aaronraj11/MES4-Carrier-EC/MES4_Carrier_EC/enclosure/preview.png

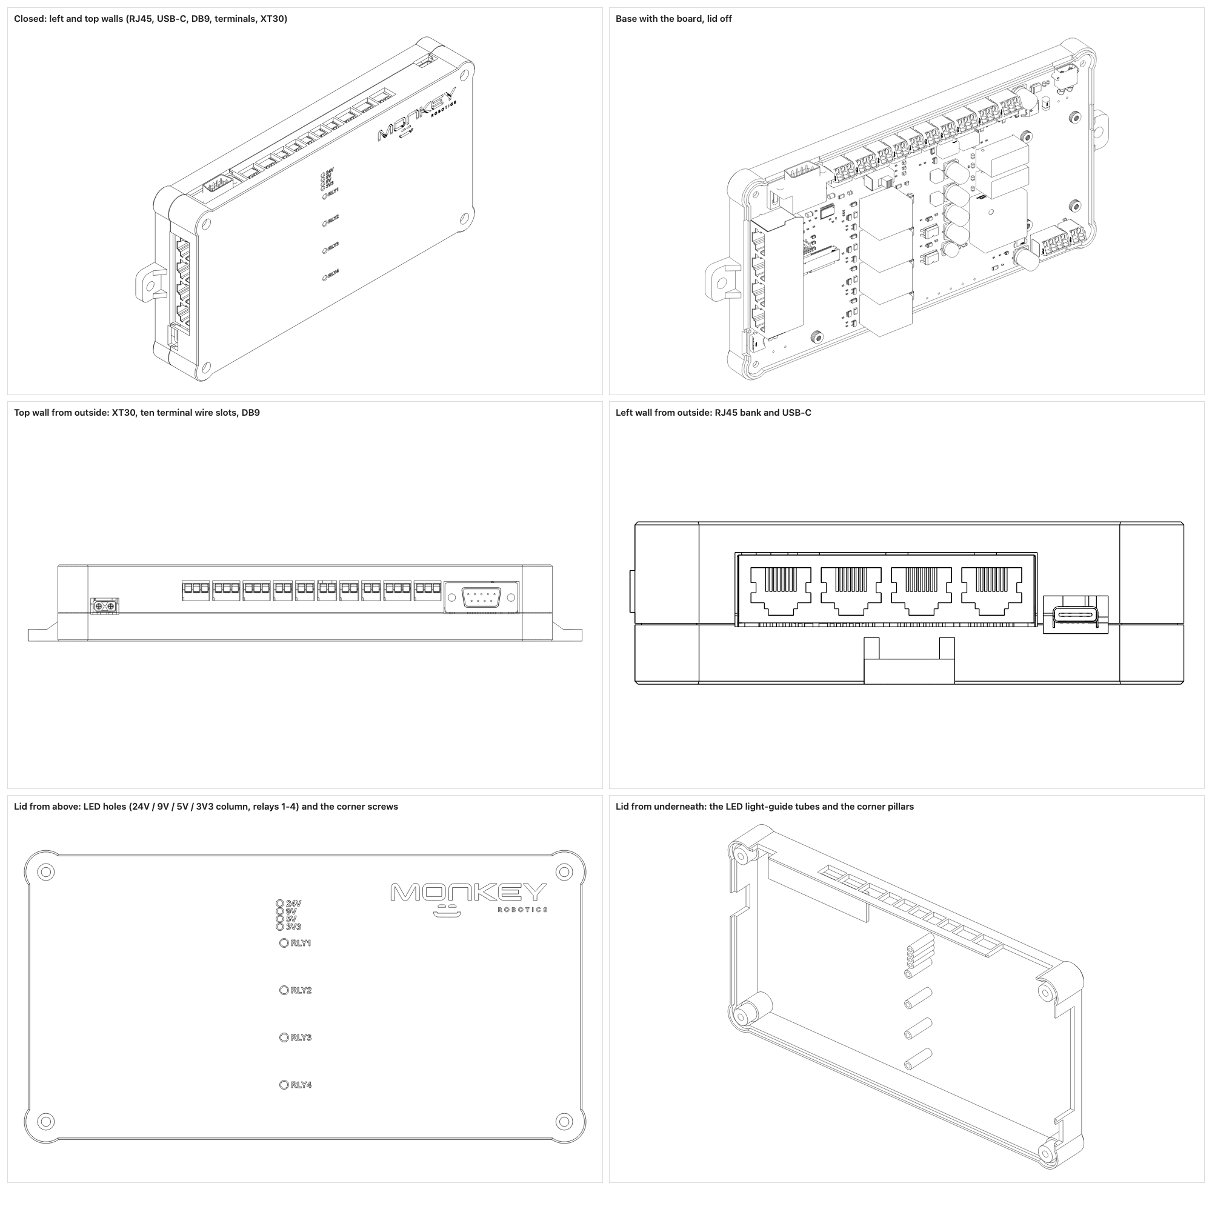
MES4_Carrier_EC/enclosure/preview.png
