aaronraj11/MES4-Carrier-EC/MES4_Carrier_EC/review/analog_guard.png

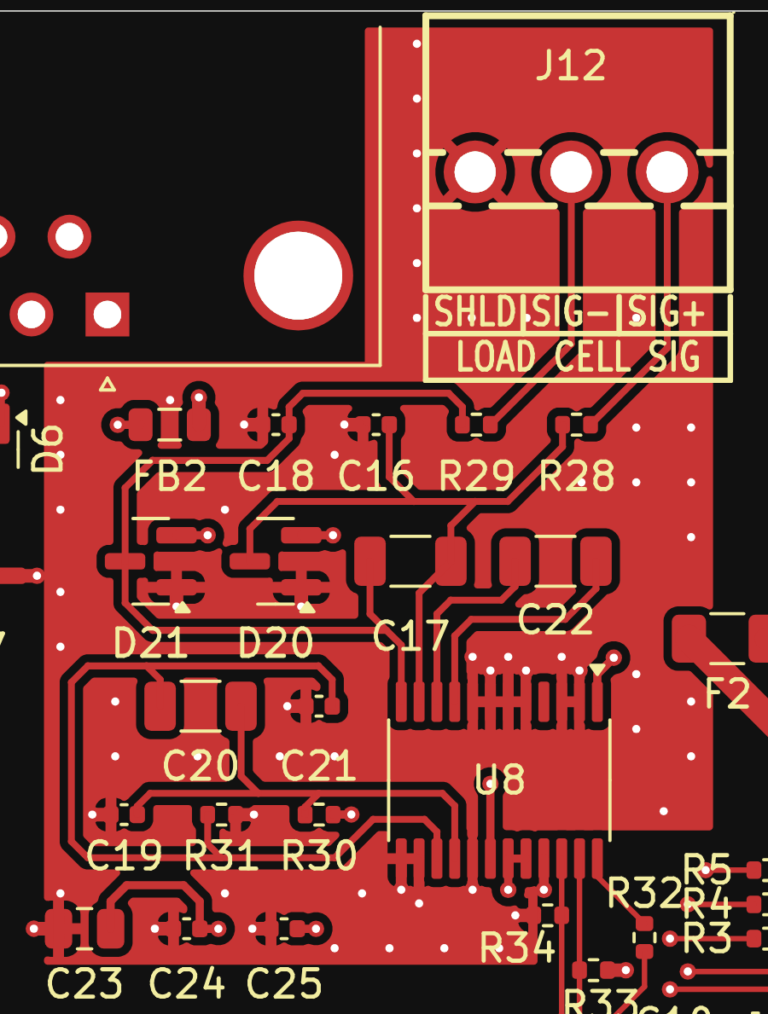
MES4_Carrier_EC/review/analog_guard.png
