aaronraj11/MES4-Carrier-EC/MES4_Carrier_EC/review/gnd_fill_B.png

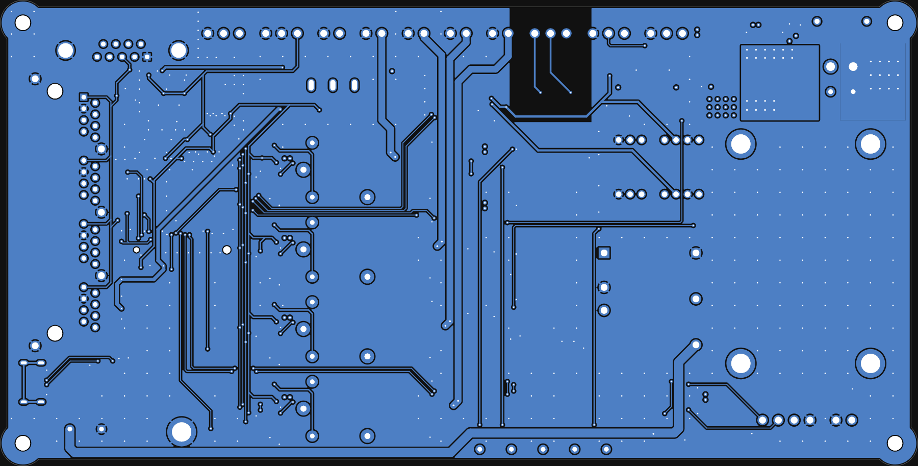
MES4_Carrier_EC/review/gnd_fill_B.png
