aaronraj11/MES4-Carrier-EC/MES4_Carrier_EC/review/gnd_fill_F.png

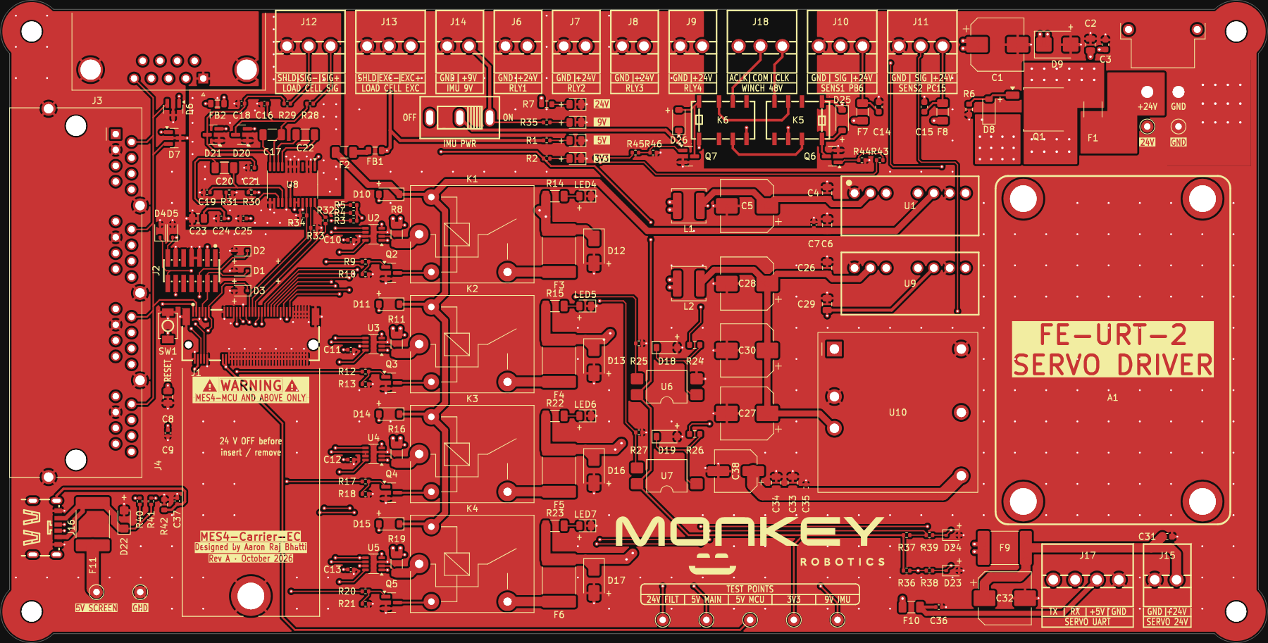
MES4_Carrier_EC/review/gnd_fill_F.png
