aaronraj11/MES4-Carrier-EC/MES4_Carrier_EC/review/plane_in1_gnd.png

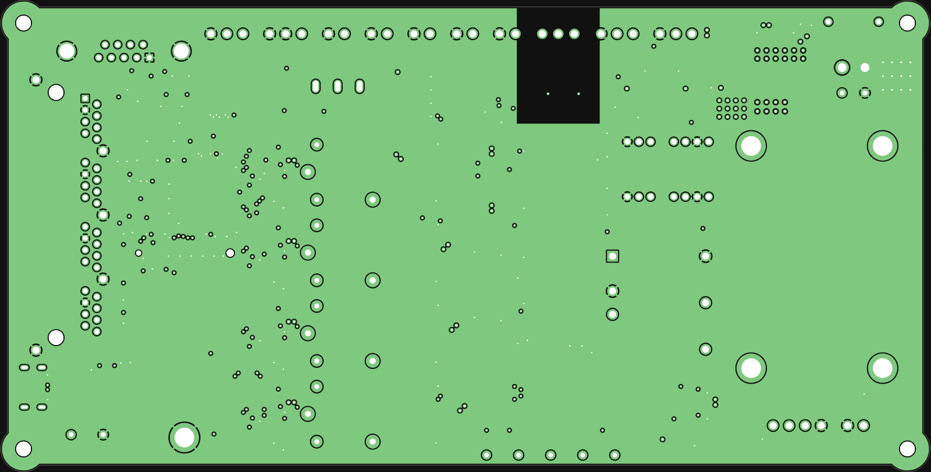
MES4_Carrier_EC/review/plane_in1_gnd.png
