aaronraj11/MES4-Carrier-EC/MES4_Carrier_EC/review/plane_in2_24v.png

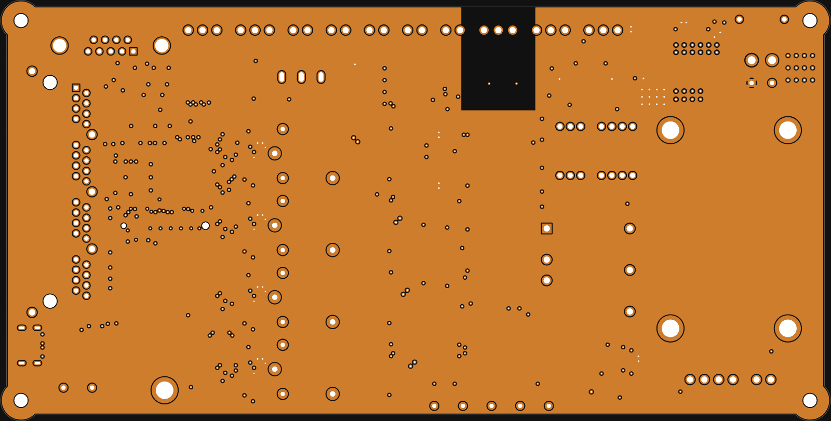
MES4_Carrier_EC/review/plane_in2_24v.png
