aaronraj11/MES4-Carrier-EC/MES4_Carrier_EC/review/routing_kelvin.png

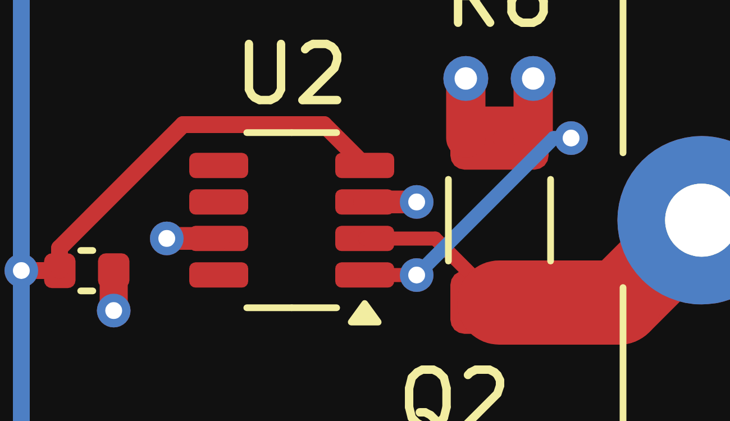
MES4_Carrier_EC/review/routing_kelvin.png
