aaronraj11/MES4-Carrier-EC/MES4_Carrier_EC/review/routing_loadcell.png

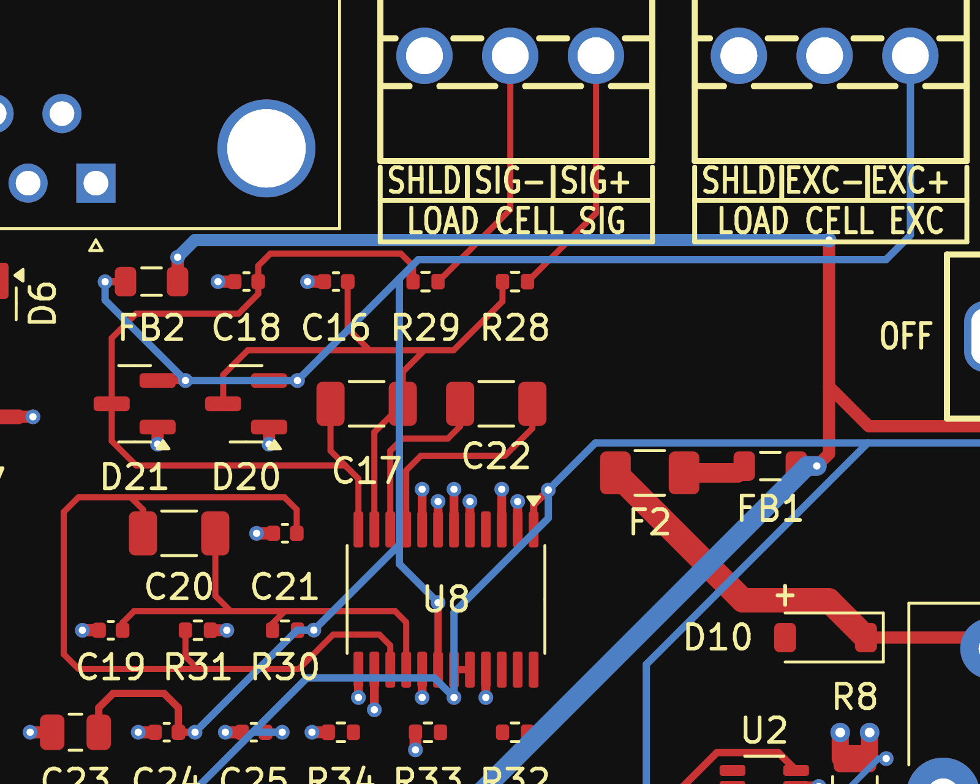
MES4_Carrier_EC/review/routing_loadcell.png
