aaronraj11/MES4-Carrier-EC/MES4_Carrier_EC/review/routing_mcu_far.png

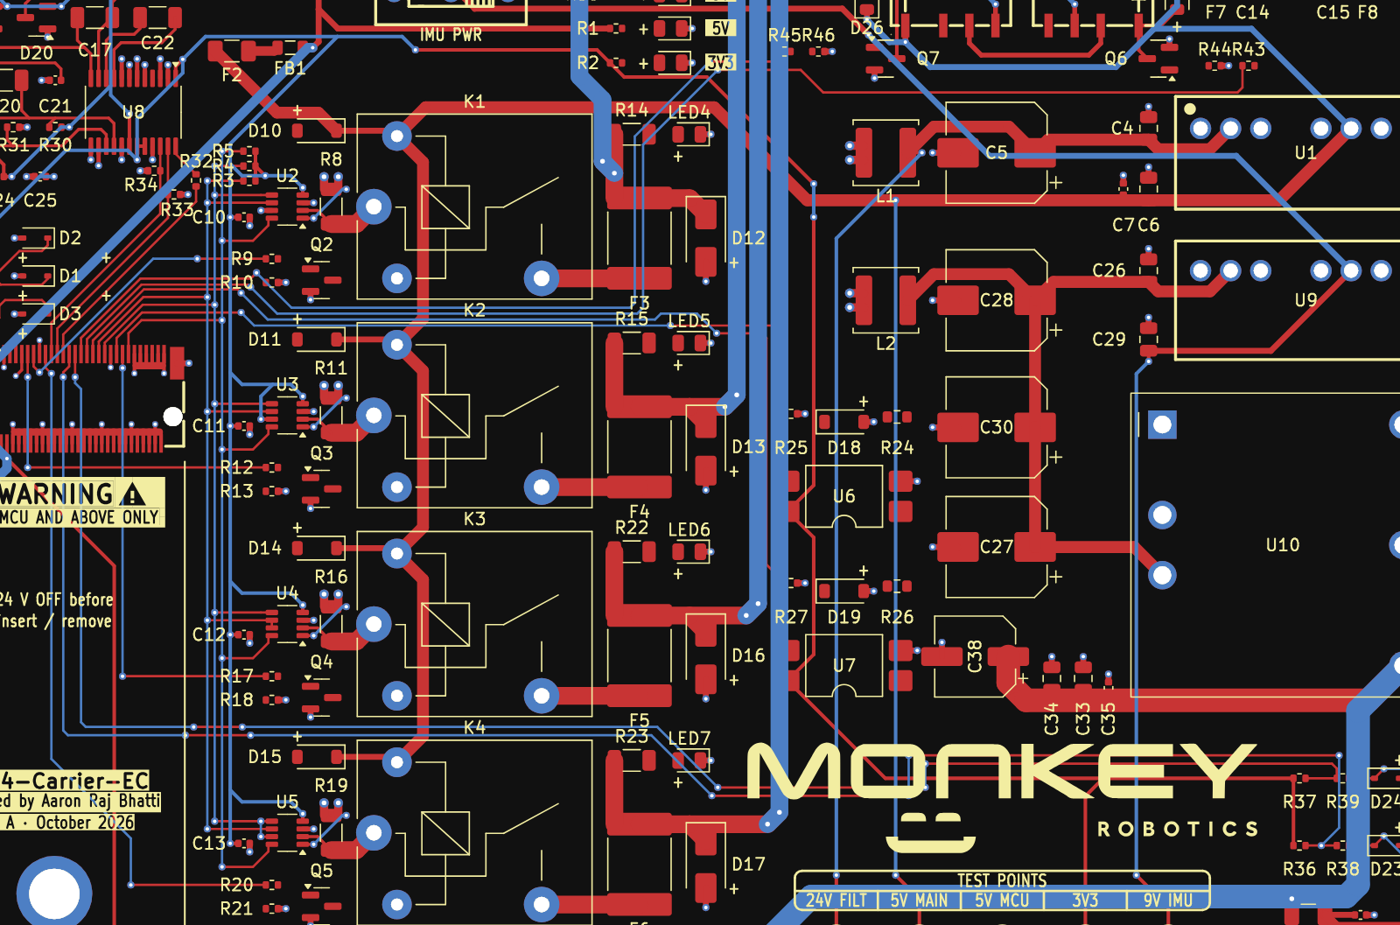
MES4_Carrier_EC/review/routing_mcu_far.png
