aaronraj11/MES4-Carrier-EC/MES4_Carrier_EC/review/routing_winch_gates.png

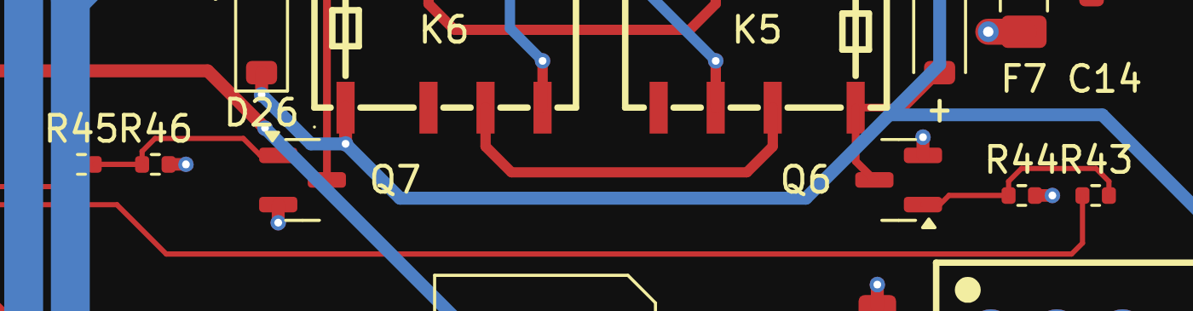
MES4_Carrier_EC/review/routing_winch_gates.png
