aaronraj11/MES4-Carrier-EC/MES4_Carrier_EC/review/silkscreen.png

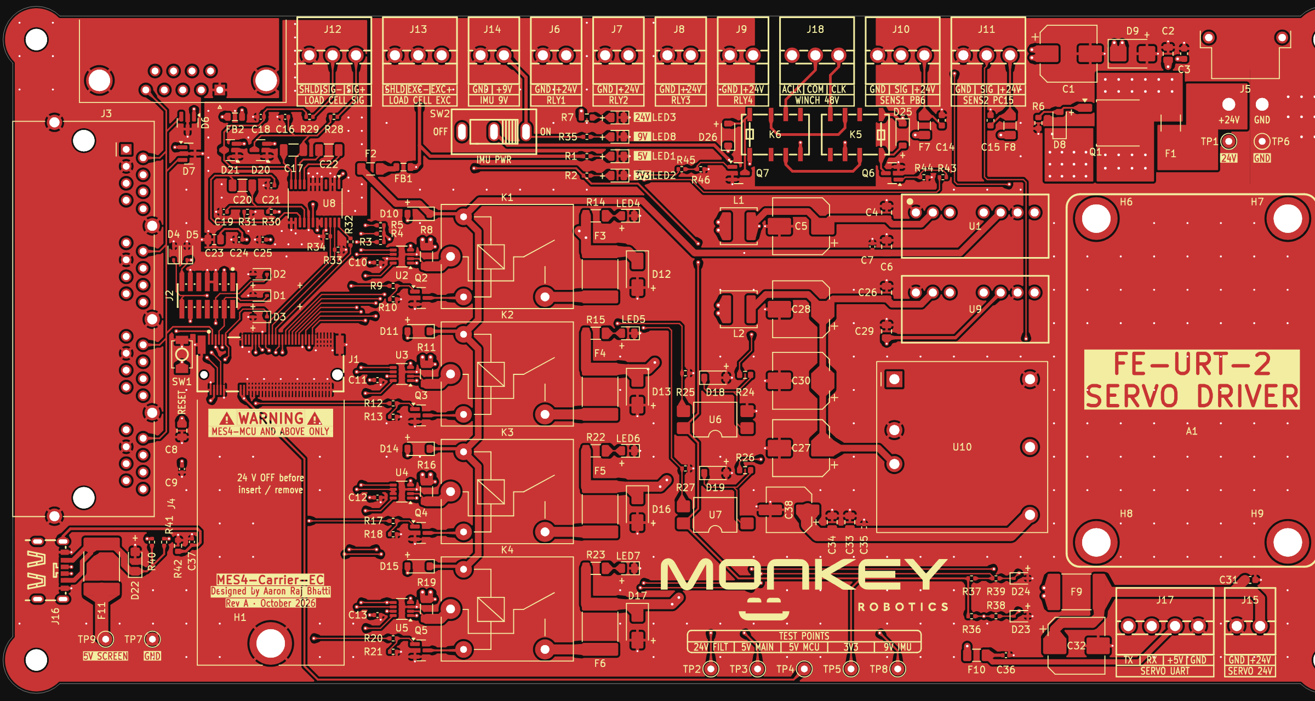
MES4_Carrier_EC/review/silkscreen.png
