aaronraj11/MES4-Carrier-EC/MES4_Carrier_EC/review/teardrops_closeup.png

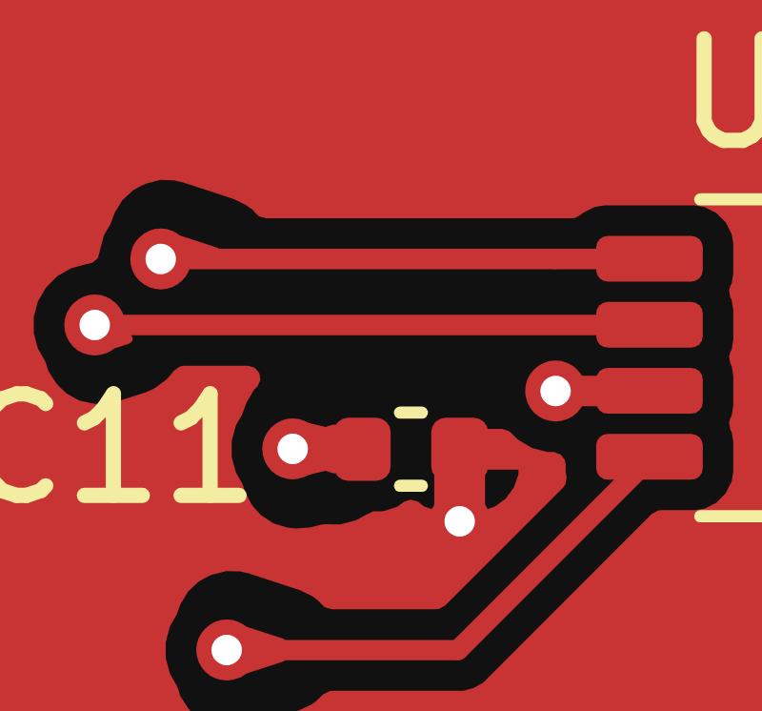
MES4_Carrier_EC/review/teardrops_closeup.png
