aaronraj11/MES4-Carrier-EC/MES4_Carrier_EC/review/tidy_mcu_fanout.png

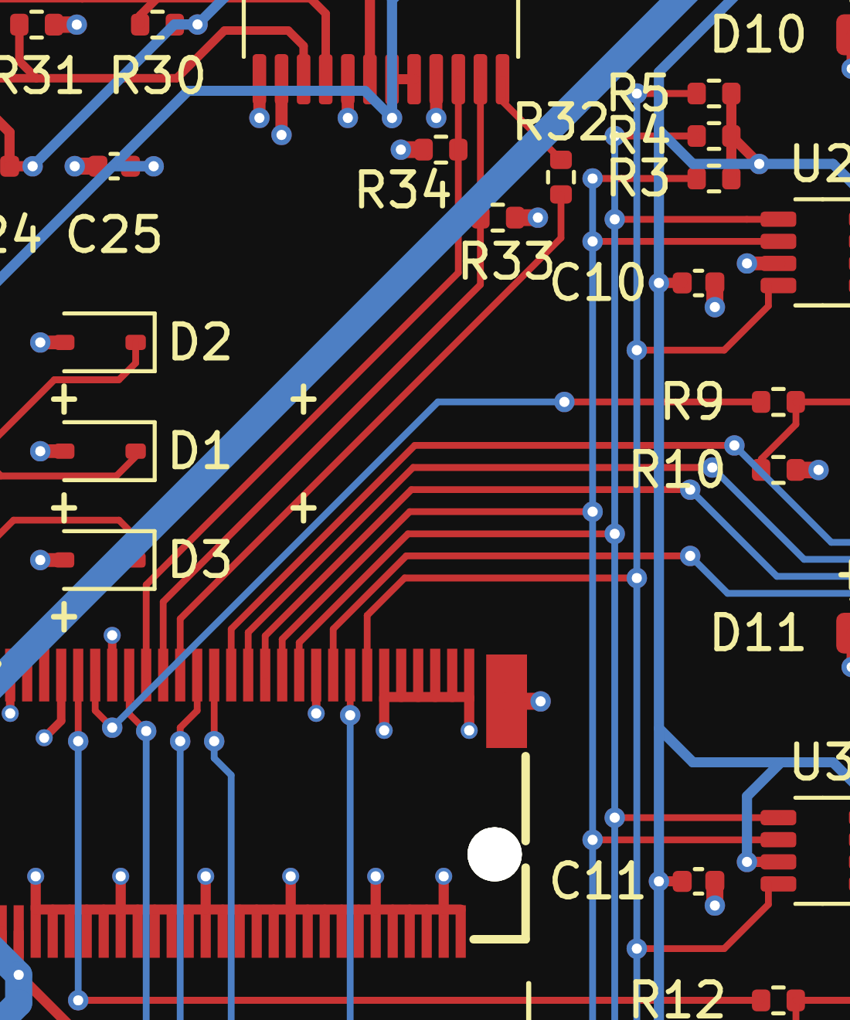
MES4_Carrier_EC/review/tidy_mcu_fanout.png
