aaronraj11/MES4-Carrier-EC/MES4_Carrier_EC/production/bom.csv

Designator | Footprint | Quantity | Value | LCSC Part #
C1, C27, C5 | CP_Elec_8x10 | 3 | 100uF 63V | C48970912
C10, C11, C12, C13, C24, C25, C35, C36, C7, C9 | 0402 | 10 | 100nF | C1525
C14, C15, C3, C31 | 0603 | 4 | 100nF 50V | C14663
C16, C18, C19, C21 | 0402 | 4 | 10nF C0G | C3855387
C17, C20, C22 | 1206 | 3 | 100nF C0G | C97946
C2, C26, C4 | 0805 | 3 | 10uF 50V | C440198
C23, C8 | 0805 | 2 | 10uF 25V | C15850
C28, C30, C32 | CP_Elec_8x10 | 3 | 47uF 100V | C48935391
C29 | 0805 | 1 | 22uF 16V | C76637
C33, C34, C6 | 0805 | 3 | 22uF 25V | C45783
C37 | 0402 | 1 | 2.2uF | C12530
C38 | CP_Elec_6.3x5.4 | 1 | 100uF 16V | C81993
D1, D2, D23, D24, D3, D4, D5 | D_SOD-323 | 7 | H5VSD3B | C20615806
D10, D11, D14, D15, D18, D19, D25, D26 | D_SOD-123 | 8 | 1N4148W | C81598
D12, D13, D16, D17 | D_SMA | 4 | SS34 | C8678
D20, D21 | SOT-23 | 2 | BAV199 | C40919
D22 | D_SMF | 1 | SMF6.0A | C19077499
D6, D7 | SOT-23 | 2 | H24VNT2B | C20615827
D8 | D_SOD-123 | 1 | MMSZ5245B | C2126
D9 | D_SMB | 1 | SMBJ30A | C113998
F1 | Fuse_Littelfuse-NANO2-451_453 | 1 | 15A | C44480
F10, F2 | 1206 | 2 | 1.1A | C126818
F11, F3, F4, F5, F6, F9 | 2920 | 6 | 3A | C22435908
F7, F8 | 1206 | 2 | 100mA | C7542926
FB1, FB2 | 0805 | 2 | 120R | C79382
H1 | Standoff_SMD_M3_H2.5mm_SMTS0M325STR | 1 | M3 standoff | C5301771
H6, H7, H8, H9 | Standoff_SMD_M3_H2mm_SMTSOM320BTR | 4 | M3 standoff 2mm | C5301780
J1 | TE_2199230-3_M.2_B-Key_4.2mm | 1 | 2199230-3 | C590859
J10 | CONN-TH_KF250NH-3.5-3P | 1 | SENS1 | C976557
J11 | CONN-TH_KF250NH-3.5-3P | 1 | SENS2 | C976557
J12 | CONN-TH_KF250NH-3.5-3P | 1 | LC SIG | C976557
J13 | CONN-TH_KF250NH-3.5-3P | 1 | LC EXC | C976557
J14 | CONN-TH_KF250NH-3.5-2P | 1 | IMU 9V | C976556
J15 | CONN-TH_KF250NH-3.5-2P | 1 | SERVO 24V | C976556
J16 | USB-C_Receptacle_PowerOnly_6P_C456012 | 1 | SCREEN 5V | C456012
J17 | CONN-TH_KF250NH-3.5-4P | 1 | SERVO UART | C976558
J18 | CONN-TH_KF250NH-3.5-3P | 1 | WINCH | C976557
J2 | Samtec_FTSH-107-01-L-DV-K_2x07_P1.27mm_Vertical_SMD | 1 | STDC14 | C5307809
J3 | DSUB-9_Pins_Horizontal_P2.77x2.84mm_EdgePinOffset7.70mm_Housed_MountingHolesOffset9.12mm | 1 | D-SUB-DR-9PCG-BB | C19077344
J4 | RJ45_HCTL_HC-RJ45-059-4-4_1x4_Horizontal | 1 | HC-RJ45-059-4-4 | C3000204
J5 | CONN-TH_XT30PW-M | 1 | 24V IN | C431092
J6 | CONN-TH_KF250NH-3.5-2P | 1 | RLY1 OUT | C976556
J7 | CONN-TH_KF250NH-3.5-2P | 1 | RLY2 OUT | C976556
J8 | CONN-TH_KF250NH-3.5-2P | 1 | RLY3 OUT | C976556
J9 | CONN-TH_KF250NH-3.5-2P | 1 | RLY4 OUT | C976556
K1, K2, K3, K4 | Relay_SPST_SANYOU_SRD_Series_Form_A | 4 | SRD-5VDC-SL-A | C140615
K5, K6 | RELAY-SMD_IMXXGR | 2 | IM03GR | C2153100
L1, L2 | L_Sunlord_SWPA5040S | 2 | 10uH | C84608
LED1 | 0805 | 1 | Red | C84256
LED2, LED3, LED8 | 0805 | 3 | Green | C2297
LED4, LED5, LED6, LED7 | 0805 | 4 | Yellow | C2296
Q1 | TO-252-2 | 1 | AGM60P90D | C5464761
Q2, Q3, Q4, Q5, Q6, Q7 | SOT-23 | 6 | AO3400A | C20917
R1, R2, R38 | 0402 | 3 | 1k | C11702
R10, R13, R18, R21, R33, R34, R44, R46 | 0402 | 8 | 100k | C25741
R11, R16, R19, R8 | 1206 | 4 | 30mΩ | C5375399
R12, R17, R20, R28, R29, R30, R31, R32, R39, R43, R45, R9 | 0402 | 12 | 100Ω | C25076
R14, R15, R22, R23 | 1206 | 4 | 3.3k | C26032
R24, R26, R6, R7 | 0603 | 4 | 10k | C25804
R25, R27, R36, R37, R40, R41, R5 | 0402 | 7 | 10k | C25744
R3, R35, R4 | 0402 | 3 | 2.2k | C25879
R42 | 0603 | 1 | 1M | C22935
SW1 | SW_SMD_TS-1088_4x3mm | 1 | RESET | C720477
SW2 | SW-TH_SHOU-HAN_SS12D10G4 | 1 | SS12D10G5 | C7431054
U1 | PWRM-TH_YLPTEC_URXXXXXS-6WR3 | 1 | URB2405S-6WR3 | C3031185
U10 | PWRM-TH_YLPTEC_URBXXXXYMD-20WR3 | 1 | URB2405YMD-20WR3 | C5369777
U2, U3, U4, U5 | TSOT-23-8_TI_DDF | 4 | INA236 | C5443912
U6, U7 | SMDIP-4_W9.53mm | 2 | PC817 | C66405
U8 | TSSOP-24_4.4x7.8mm_P0.65mm | 1 | ADS1232IPWR | C27919
U9 | PWRM-TH_YLPTEC_URXXXXXS-6WR3 | 1 | URB2409S-6WR3 | C7468814
