aaronraj11/MES4-Carrier-EC/MES4_Carrier_EC/enclosure/MES4-Carrier-EC_base.step

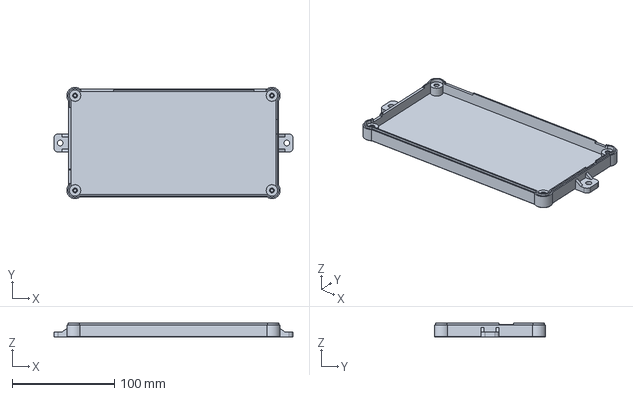
[picture p25: CAD file, 2026-10-29]
MES4_Carrier_EC/enclosure/MES4-Carrier-EC_base.step
234.2 x 109.1 x 13.6 mm
