aaronraj11/MES4-Carrier-EC/MES4_Carrier_EC/enclosure/MES4-Carrier-EC_lid.step

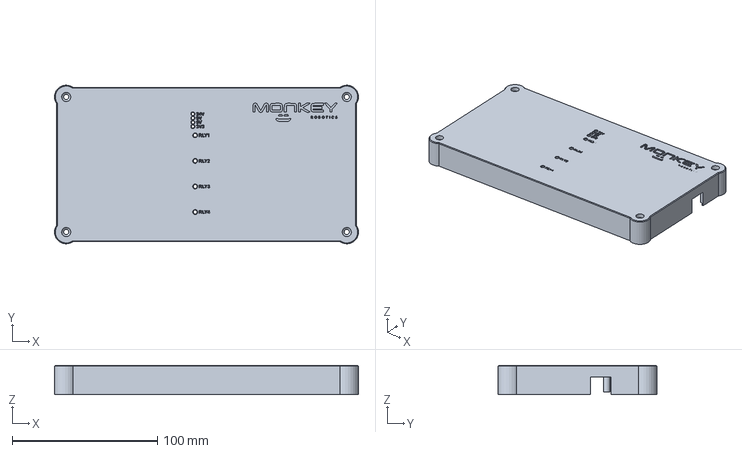
[picture p27: CAD file, 2026-10-29]
MES4_Carrier_EC/enclosure/MES4-Carrier-EC_lid.step
209.1 x 109.1 x 20.2 mm
