aaronraj11/MES4-Carrier-EC/(list of files, cad)

Other CAD files:
MES4_Carrier_EC/enclosure/MES4-Carrier-EC_base.stl
MES4_Carrier_EC/enclosure/MES4-Carrier-EC_lid.stl
