aaronraj11/MES4-Carrier-EC/MES4_Carrier_EC/review/cpl_r4_fix.png

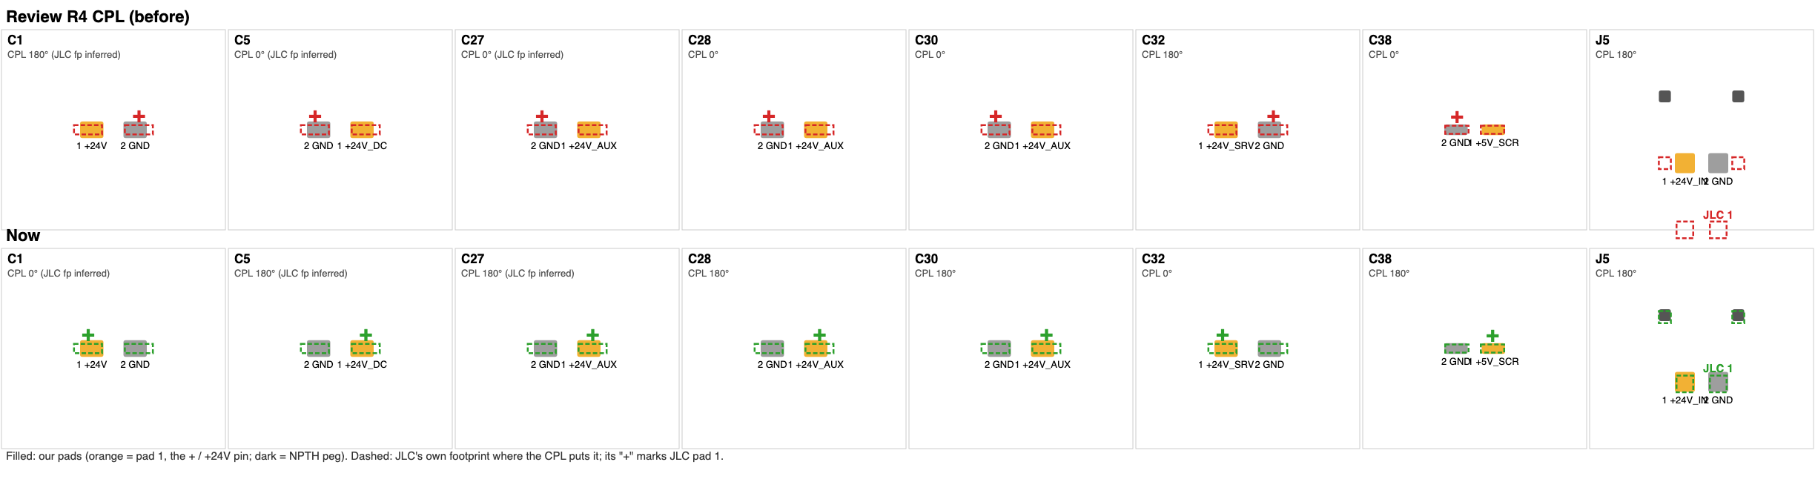
MES4_Carrier_EC/review/cpl_r4_fix.png
