aaronraj11/MES4-Carrier-EC/MES4_Carrier_EC/review/MES4_Carrier_EC_1to1_A4.pdf

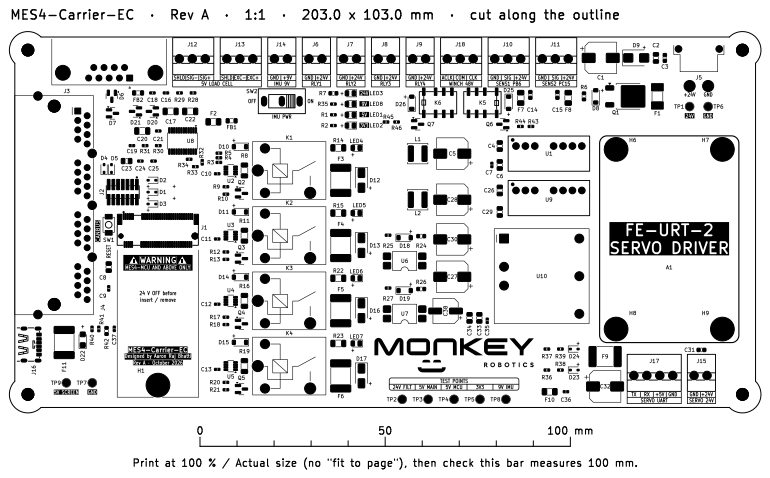
[picture p29: page 1]
