aaronraj11/MES4-Carrier-EC/(commit log)

2026-10-27 Add the MES4-Carrier-EC schematic, generator and handoff notes
    E-Crawler carrier for one MES4-MCU module, ten A3 pages, built from the
    MES4-Flasher sheets plus new blocks. ERC: 0 errors, 0 warnings; every
    symbol pin has a footprint pad and every bought part an LCSC number.
    - 24 V XT30 input: 15 A fuse, P-MOSFET reverse-polarity block, SMBJ30A,
    pi filters, URB2405S-6WR3 logic supply and a fused module 5 V feed.
    - Four relay outputs per MES4-CIF section 7: AO3400A, coil feedback,
    INA226 per channel, 3 A PTC.
    - Two Autonics PNP sensor inputs (PC817) and the Flasher's ADS1232 load
    cell.
    - CAN: DB9 male to the IPC (1 GND, 3 CAN_H, 5 CAN_L) and a 1x4 RJ45
    without magnetics, H24VNT2B ESD a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
2026-10-27 Put relay coil feedback back on PA0-PA3 (MES4 GPIO standard)
    All 14 module GPIOs now follow the MES4-CIF §2c table. The TCA9535 is
    removed from the Relays 3-4 sheet and J1 fingers 43/45/47/49 drive the
    relay 1-4 feedback dividers again. The winch relays are left undriven
    (gate inputs no-connected, 100k pull-downs hold them off) until they
    move to the TCA9535 + photoMOS design (HANDOFF.md step 2).
    Removing U4 renumbers U5-U12 to U4-U11 and C15-C45 to C14-C44; the
    README refs follow. Adds generator/checks.py (pin/pad, single-pin nets,
    duplicate UUIDs, LCSC numbers), run by run.sh after ERC.
2026-10-27 Drop relay coil feedback; winch on PA0/PA1, servo on USART2
    User decision: free the four feedback pins instead of adding an I²C
    expander. The Flasher template's 10k/15k/10 nF dividers are removed from
    all relay channels and relay diagnosis is INA226-only. PA0/PA1 drive the
    IM03GR winch relays again and PA2/PA3 carry the door servo UART
    (USART2), so the SC16IS740 bridge, its crystal and caps, and the unused
    TCA9535 code are removed. This deliberately differs from the MES4-CIF
    §2c GPIO table; the GPIO map, root notes, README and HANDOFF say so.
    189 parts, ERC clean, checks.py passes. README refs follow the
    renumbering.
2026-10-27 Add module finger map page and FE-URT-2 3.3 V note
    New page 11 (Pinout): a KiCad table of every MES4-MCU finger with its
    STM32 port, function, what this carrier connects to it, the carrier
    parts, the MES4-CIF §2c standard use and notes. It follows the MES4-MCU
    U1 pin map style (colour-coded Function column, spanned finger-group
    rows); the PA0-PA3 rows mark where this board differs from §2c. The
    builder gains table() with per-cell fills and row spans, and cell text
    resolves {tag} references.
    The AuxPower servo note, README and HANDOFF now say to set the FE-URT-2
    level switch to 3.3 V: at 5 V its TX exceeds PA3's limit while the
    module is unpowered and back-feeds the 3V3 through the RX pull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
2026-10-27 Isolate the 48 V winch side, add servo TX pull-up, tidy block diagram
    Winch: J18 and the WINCH_* / ILK_* nets already touch only relay
    contacts; they now form net class Winch_48V (0.6 mm clearance), and the
    Winch sheet, README and HANDOFF state the isolation rules (>= 2 mm to
    other copper, no GND pour under J18, no ESD to GND on J18).
    Servo: R37 10k pull-up holds PA2 (TX) idle HIGH while the MCU is in
    reset. AuxPower/Winch refs R37-R45 shift by one; README follows, and the
    LED8 resistor ref is corrected to R35.
    Block diagram: door servo block, winch and servo links from the module,
    24 V routed so it never crosses a signal line, channel lines on an even
    5.08 mm pitch.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
2026-10-27 Address design review R1: INA236, J15 polarity, review fixes
    M1: U2-U5 are now TI INA236AIDDFR (C5443912, 50 V abs max, TSOT-23-8)
    instead of the INA226 (40 V), since the SMBJ30A clamps at up to 48.4 V.
    A project INA236 symbol keeps the INA226 body so the Flasher relay
    wiring lands on the same pins; A1 and VBUS are gone (bus read on IN-),
    addresses 0x40-0x43 via A0 = GND / VS / SDA / SCL. Same CONFIG / CAL /
    MASK / ALERT values; notes give the 1.6 mV bus LSB and Device ID.
    M3: J15 servo 24 V is pin 1 = +24 V like every power terminal.
    L4: R38 servo RX series resistor 1k (limits PA3 back-feed).
    L2: "current present" threshold 3 mA. L6: Power notes use 13 A / 2.2 W.
    M2 / L5: silkscreen notes f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
2026-10-27 Add whole-board LTspice simulations, IMU notes and the R2 review package
    sim/: 16 LTspice benches grouped by schematic sheet (Power, Relays,
    Sensors, LoadCell, AuxPower, IMU, Winch, Main) on the real supply chain
    (DDR-480C-24 at 24 V and a 24 V Li-ion pack via XY-CD63L, diode-OR'd by
    an Autoro AB20). run_sims.py runs them, make_report.py builds
    report.html. All pass; the IEC 0.5 kV surge is not applicable to this
    internal, isolated supply. Raw waveforms and logs are git-ignored.
    IMU: 3DM-CV7-AHRS on the C-Series Connectivity Board (6212-3009). The
    AuxPower and Main notes, README and HANDOFF now say J14's 9 V goes to the
    board's Vaux only (never Vpri), not together with the USB cable; the
    po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
2026-10-27 Record datasheet checks in the report, review package and HANDOFF
    All three pass: U1 / U9 / U10 YLPTEC converters allow a 50 V input surge
    for 1 s (PWR2 peaks at 40 V); Q1 AGM60P90D is rated -360 A pulsed (plug-in
    inrush 100 A); F1 Littelfuse 0451015 melting I2t is 97.8 A2s (inrush
    0.95 A2s). PWR2 is now a plain pass, and the hold-up note mentions the
    converters' 5.5-6.5 V undervoltage shut-off. Review package rebuilt.
2026-10-27 Import all footprints into the PCB; TI land pattern for the INA236
    MES4_Carrier_EC.kicad_pcb: all 190 footprints and 146 nets, grouped by
    schematic sheet below the 200 x 100 mm outline, ready to place. Each
    footprint carries its symbol path (F8 updates it instead of duplicating),
    nets, LCSC number and BOM setting. DRC: schematic parity 0 issues,
    0 clearance errors; 450 unconnected items (unrouted).
    generator/import_footprints.py does the one-time import with KiCad's
    pcbnew Python and refuses a board that already has footprints.
    U2-U5 INA236 now use the project footprint TSOT-23-8_TI_DDF (TI DDF0008A
    land pattern: 1.05 x 0.45 mm pads, rows 2.6 mm apart). KiCad's generic
    TSOT-23-8 left 0.15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
2026-10-27 Group footprints that must sit together into KiCad groups
    generator/group_footprints.py puts all 190 footprints into 21 named
    groups (24 V input, logic DC/DC, module 5 V feed, GND joint, M.2 socket,
    ST-Link, mounting holes, DB9, RJ45, one per relay channel with its shunt
    and INA236, one per sensor, load cell, aux filter, IMU, screen, servo,
    winch) and packs each as a labelled block below the board outline. Parts
    already inside the outline are not moved; old labels and groups are
    stripped from the file text first, so it can be rerun (KiCad closed).
    DRC: schematic parity 0 issues, no clearance errors; 450 unconnected
    items (unrouted). HANDOFF lists the script.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
2026-10-27 Centre the mounting holes on the board's dog-ears
    H2-H5 (M3, 3.2 mm) sit on the centres of the four 5 mm Edge.Cuts
    dog-ear arcs, taken from the outline itself: (53.4355, 52.9355),
    (246.3645, 52.9355), (246.3645, 145.8645), (53.4355, 145.8645).
    All four are locked. DRC unchanged: schematic parity 0 issues, no
    clearance errors.
2026-10-27 PCB placement, FE-URT-2 and GPS mounts, smaller screen converter, review R3
    Placement: all terminals, USB-C and XT30 face the top edge (CAN DB9/RJ45 on
    the sides), power block (U1, U9, U10, filters, GND joint) under the 24 V
    input, relay bank and winch block below the terminal row, MES4-MCU slot
    grouped with the Flasher's slot silkscreen. Feetech and GPS mounts parked
    off-board until the layout is final.
    Mounts: FE-URT-2 on 4 x YIYUAN SMTSOM320BTR M3 x 2 mm SMD standoffs (H6-H9,
    C5301780) as on the MES3 carriers, board-only outline with a footprint
    keep-out; simpleRTK4 Dual on 3 x SMTSOM365BTR M3 x 6.5 mm standoffs
    (H10-H12, C5301796) + 12 mm spacers, with its STEP.
    U10: URB2405LD-20WR3 (2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
2026-10-27 Add the EasyEDA 3D model to U10 (URB2405YMD-20WR3)
    STEP from the EasyEDA/LCSC library part C5369777. Its origin is the body
    centre on the board surface and its pins land on the footprint's pads
    (checked in FreeCAD), so no offset or rotation. Attached in the footprint
    builder, the library footprint and U10 on the PCB.
2026-10-27 Place every part, tidy the converter block, leave out the GPS mount
    - Converter block: U1/U9/U10 right-aligned in one line beside the
    FE-URT-2 (2.5 mm channel), all their caps on the left in routing lanes.
    - STDC14 (J2) and RESET above the M.2 connector, ESD diodes beside J1;
    ADS1232 load-cell front end below the MES4-MCU; sensor optos below the
    converter block.
    - Supply LEDs (24V/9V/5V/3V3) in one array with knockout voltages, as on
    the Flasher; pull-ups beside it.
    - Terminal label boxes on the FE-URT-2 connectors J17/J15 (moved up 2 mm).
    - GPS (simpleRTK4) mount left out for now: GPS_MOUNT = False in gen.py
    drops H_GPS1-3; A2 and the standoffs are off the PCB.
    - Top-row reshuffle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
2026-10-28 Add the EasyEDA 3D model to the 1x4 RJ45 (J4, HC-RJ45-059-4-4)
    The generated footprint had no model. The LCSC/EasyEDA STEP of C3000204 is
    aligned on its pegs and seating plane (measured in FreeCAD): offset
    (71.495, -10.31, 13.5) mm, no rotation.
2026-10-28 One ground and a 4-layer board
    - GND_24V merged into GND (ONE_GND in gen.py): every GND_24V power symbol
    becomes GND, net tie NT1 left out, notes reworded. Symbol UUIDs unchanged,
    so every footprint keeps its link.
    - 4 layers, JLC04161H-7628 stackup (1.6 mm, ENIG): Top Signal / GND plane
    (In1) / +24V plane (In2) / Bottom Signal.
    - Net classes: Out_3A (1.5 mm) for +24V_SRV, +5V_SCR, VBUS_SCR; +24V_AUX to
    24V_Power; +5V_SRV, +9V_IMU, IMU_9V to Power; INA236 shunt pattern fixed
    (Net-(U*-IN-)).
    - J1's NPTH holes back to F&B.Cu as in its library footprint.
    ERC 0, checks passed, DRC 11 silkscreen warnings, schematic parity clean.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
2026-10-28 Placement and silkscreen pass: ADS by the load-cell inputs, test points, logo
    - Left column top to bottom: ADS1232 under J12/J13 (input filter toward the
    connectors), STDC14 + ESD grid, then the MES4-MCU slot moved down 22.3 mm;
    RESET (SW1) beside J1 with the 5 V socket caps C8/C9.
    - Test points named by what they feed (TP_NAME in gen.py: 24V, 24V FILT,
    5V MAIN, 5V MCU, 3V3, 9V IMU, 5V SCREEN); bottom row in a Flasher-style
    rounded box, 24V/GND under the XT30, 5V SCREEN/GND by the screen USB-C.
    - Supply LEDs centred between SW2 and the winch block; short knockout labels
    all one box size (drawn as cut-out silk shapes).
    - + at the anode of every two-pin diode and LED; SW2 marked IMU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
2026-10-28 GND vias for every SMD GND pad
    106 vias (0.6/0.3) to the In1 GND plane, each on one straight 0/90-degree stub
    straight off the end of its pad (IC pins straight out along the pin), 0.1 mm
    from the pad edge; U8's 0.65 mm pins staggered to 0.6 mm for hole spacing.
    Vias keep clear of other parts, board silkscreen and the escape lanes of
    fine-pitch signal pins; labels in the way moved instead. J1's 0.3 mm M.2
    fingers are left for the escape routing.
    Made room: ESD grid at 3.2 mm pitch with + under each anode, J2 label vertical
    on its left, C8/C9 GND pads down, LED voltage boxes 0.6 mm out, D22 down 1.5 mm;
    diode + marks re-placed beside the anodes.
    DRC 14 silkscreen warnings, schematic parity c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
2026-10-28 Net classes sized by current, +24V plane vias, fused M.2 GND bars
    - Net classes by current: Power_Small 0.3, Power 0.5, 24V_Power 1.0,
    Out_3A 1.5, Input_15A 3.0, Winch_48V 0.6 clearance, CAN and LoadCell
    pairs; router track, via and diff-pair presets
    - +24V vias into the In2 plane, one pattern per part type: two vias
    across the pad end on the shunts (R8/R11/R16/R19), L1/L2, F9, C1, D9;
    one via on the small parts; all straight off the pad
    - J1 (M.2): GND vias on every GND finger, inward under the socket body;
    runs of 3+ GND fingers (24-74, 65-75) fused by a bar with a few vias
2026-10-28 Handoff: PCB state, routing order, workflow; PCB helper scripts
    - HANDOFF.md "Start here": what's done on the PCB, net classes, DRC
    baseline, the 13-group routing order, the KiCad workflow and the
    user's via style
    - generator/pcb/: the GND / +24V / J1 via scripts and the strip helpers
2026-10-28 Route high-current paths and supply rails by hand
    High current: 24 V input pours (J5 -> F1 -> Q1, drain copper on both
    layers with thermal vias, +24V via field into In2, GND pours and vias at
    J5, J5 pins solid to the planes); relay load paths at 1.5 mm with every
    output on a B.Cu lane; servo 24 V above J17; screen 5 V on a 2 mm B.Cu
    trunk to F11 / J16.
    Supply rails: +24V_DC, +24V_AUX, +5V_24 (relay and winch coils), module
    5 V, +3V3_MOD, IMU 9 V, servo 5 V, sensor supplies and the test points.
    All paths are hand-placed coordinates in generator/pcb/route_*.py:
    45-degree bends only, one width per run, and the load-cell inputs,
    pull-up pads and J1 escapes kept free. LC_EXC+ is left for the
    loa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
2026-10-28 Route the winch relays by hand, isolate them from the planes
    J18 to K5 / K6 contacts and interlock: CLK and COM-to-K6 on F.Cu,
    ACLK and COM-to-K5 dropped from J18's through-hole pins on B.Cu to a via
    under the relay body (J18's order is mirrored against K6's pins),
    ILK_CLK between the relays' pin rows, ILK_ACLK below them. Coil drive
    to the flyback diodes and FETs; K6's coil+ gets its own via onto the
    B.Cu +5V_24 feed so coil- stays 2 mm from the live unused NC1 pin.
    A no-pour rule area on all copper layers keeps the GND / +24V planes
    (and any later outer GND fill) 2 mm off J18, the contacts and the
    winch vias. winch_clear.py checks the 2 mm rule on every layer.
    Shared path helpers moved t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
2026-10-28 Route the analog front ends, CAN bus and servo UART by hand
    INA236 Kelvin pairs: 0.25 mm sense lines tapped at the shunt pads; IN+
    crosses IN- on B.Cu between two vias (pin order vs shunt pads), same
    pattern on all four channels.
    Load cell: input pair, CAPA / CAPB and the REFP / REFN network all on
    F.Cu with no vias; LC_EXC+ joins FB2, the clamp diodes, J13, AVDD, R30
    and C24 on B.Cu.
    CAN bus J3 - D6 - D7 - J4 ports 1-4 down x 72.9, L on F.Cu and H on
    B.Cu (each RJ45 port's H pin sits beside its L pin). Servo UART at J17
    on B.Cu past the +24V_SRV tracks.
    J1's fingers (CAN / UART ends, debug, I2C, GPIO) are left for the
    planned MCU escape.
    DRC: the 14 accepted notes, schematic parity 0, 8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
2026-10-28 Finish routing: MCU escape, local nets, verify and tidy
    Route every remaining connection by hand (0 unrouted, DRC at the 14
    accepted notes, schematic parity 0):
    - MCU escape off J1: west corner (CAN, SWD, NRST, VCP to J2 / SW1 /
    D1-D5), ADC lines, relay gates, I2C / PA15 bus, far-east GPIO
    - local nets: relay drive, winch gates, sensor inputs, LEDs, screen
    USB-C CC and shield
    - placement moves for routability (R3-R5, D4/D5, D1/D2, R32-R34,
    a few J1 / J2 GND vias); +3V3 trunk moved east of the SWD crossings
    Verify and tidy: verify_nets.py checks the board against the schematic
    netlist and copper connectivity; audit.py reports bends, tees, jogs and
    uneven bundles (now none on any net);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
2026-10-28 Add the analog GND guard; check the planes
    - Analog guard: a priority-2 GND zone on F.Cu around the load-cell path
    (J12 -> R28/R29 -> filter caps / clamps -> ADS1232, REF / CAP caps),
    0.3 mm from the analog lines, kept off the ADS1232's digital corner and
    J3, stitched to In1 by 40 vias
    - Planes checked: every zone fills as one piece (no islands), no starved
    thermals, no via slots; only winch nets cross the winch cut-out
    - Renders of the guard and both inner planes
2026-10-28 Add outer GND fill, teardrops and the silkscreen pass
    - route_local.py fill: GND pours on F.Cu / B.Cu at priority 0 (24 V-input
    pours raised to 1, analog guard 2), moat round the analog guard,
    5 mm stitching-via grid to In1; U7 pin 2 connected solid.
    - teardrops.py: KiCad-style straight pad / via teardrops on every
    non-GND track end, centred on the track axis.
    - silk.py: drop the unprintable 0.12 mm pin-1 dots (board and the 10
    project-library footprints), widen strokes to 0.15 mm, move crowded
    labels, put the 19 fab-only refs on silk (H2-H5 stay unlabelled),
    keep labels off vias. silk_audit.py checks labels on glyph extents.
    - DRC back to the 3 accepted J4 edge notes; HANDOFF an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
2026-10-28 Add a JLC DFM check; keep copper 0.4 mm off bare holes
    - dfm.py: KiCad DRC on a copy of the board with JLCPCB's published
    4-layer limits as custom rules, plus the checks DRC can't do (vias in
    pads, slots, mask webs, smallest features, stackup, outline corners).
    - route_local.py fill: every NPTH pad (H2-H5, J1 / J4 pegs) gets a
    0.4 mm local clearance; planes and pours were 0.26 mm off the wall
    (JLC: 0.3 mm inner). Fill fragments unchanged.
    - Everything else passes with margin; 198 silk-near-own-pad notes and
    the 3 J4 edge notes accepted as cosmetic. HANDOFF updated.
2026-10-28 Add the first JLC fabrication outputs (Fabrication Toolkit)
    - production/: Gerbers + drill zip, BOM, CPL (positions), designators
    and IPC netlist from KiCad's Fabrication Toolkit, generated from the
    board at f58923a. BOM / CPL not yet verified (LCSC numbers, rotations).
    - fabrication-toolkit-options.json: the toolkit's settings.
    - MES4_Carrier_EC.kicad_pro: KiCad's re-save (net classes reordered,
    solder mask to copper 0.005 mm); DRC unchanged at the 3 J4 notes.
    - .gitignore: the toolkit's production/backups/.
2026-10-29 Fix design review R3 findings: U9 part, stale LCSC fields, labels, J16
    - B1: U9 is now YLPTEC URB2409S-6WR3 (C7468814, 9 V 6 W) on U1's
    footprint; the 10 W URB2409S-10WR3 isn't in JLC's assembly library.
    The production BOM had a 5 V module at U9 and the wrong SW2 because
    EasyEDA footprints carry an "LCSC Part" field the Fabrication Toolkit
    reads first: libs.py strips it (and the unprintable pin-1 dots it was
    copying back), and the new parts_sync.py syncs board footprints,
    values, fields and BOM flags from the schematic. TP1-TP9 and H2-H5
    are out of the BOM and CPL.
    - M2 / L5: "5V LOAD CELL" across J12 / J13; "CANBUS" knockout by J4.
    - B2: J16 moves 1.25 mm west so its mouth rea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
2026-10-29 Check CPL rotations against JLC's footprints; fix Q1, K1-K4, J5
    - cpl_check.py: fetches each LCSC part's EasyEDA footprint, matches
    pads (polarity names, numbers or shape), fits the rotation / offset
    JLC needs and compares with production/positions.csv.
    - Q1 (TO-252) needs +180 deg and -1.8 mm, K1-K4 (SRD relays) +180 deg,
    J5 (XT30) +9.7 mm: set as Fabrication Toolkit FT Rotation / Position
    Offset fields on the symbols (gen.py, parts.py), copied to the board
    by parts_sync.py.
    - production/ regenerated with the toolkit CLI: 169 of 181 placements
    match JLC; C1 / C5 / C27 (no JLC footprint) to check in the preview.
    - HANDOFF updated.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
2026-10-29 Fix design review R4 (CPL), add 3D models, STEP and the enclosure
    Review R4:
    - E1 (blocking): the Fabrication Toolkit turns every CP_Elec 180 deg, but
    JLC's footprints for C1/C5/C27/C28/C30/C32/C38 have + on the same side
    as ours, so all seven would have been fitted reversed. gen.py now sets
    FT Rotation Offset 180 on every CP_Elec part (the toolkit adds it to its
    own 180), so the CPL keeps the board rotation.
    - E2: J5's FT Position Offset 0,9.7 put the XT30 10 mm off; JLC's origin
    is ours. Removed; parts_sync.py now drops FT fields the schematic no
    longer has.
    - E3: parts_sync.py keeps H2-H5's empty LCSC field (KiCad 10 field parity).
    - cpl_check.py rewritten as a gate: places JL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
2026-10-29 Add a root README; keep the sim report as PDF; main is the only branch
    - README.md at the repository root so GitHub shows the board, with the
    routed-PCB render and a map of MES4_Carrier_EC/
    - sim/report.pdf: the LTspice report printed from report.html (the .raw
    outputs are gitignored and were cleared; run_sims.py recreates them)
    - HANDOFF.md: work happens on main (mes4-gpio-standard was merged into it)
